PieterHaase/RPi-404/Version 1.0 (veraltet)/README.md

# README #

Projekt ITS/MoSy
Sommersemester 2018
Gruppe: RPi-404
