PieterHaase/RPi-404/Version 1.0 (veraltet)/Signalflussgraph.pdf

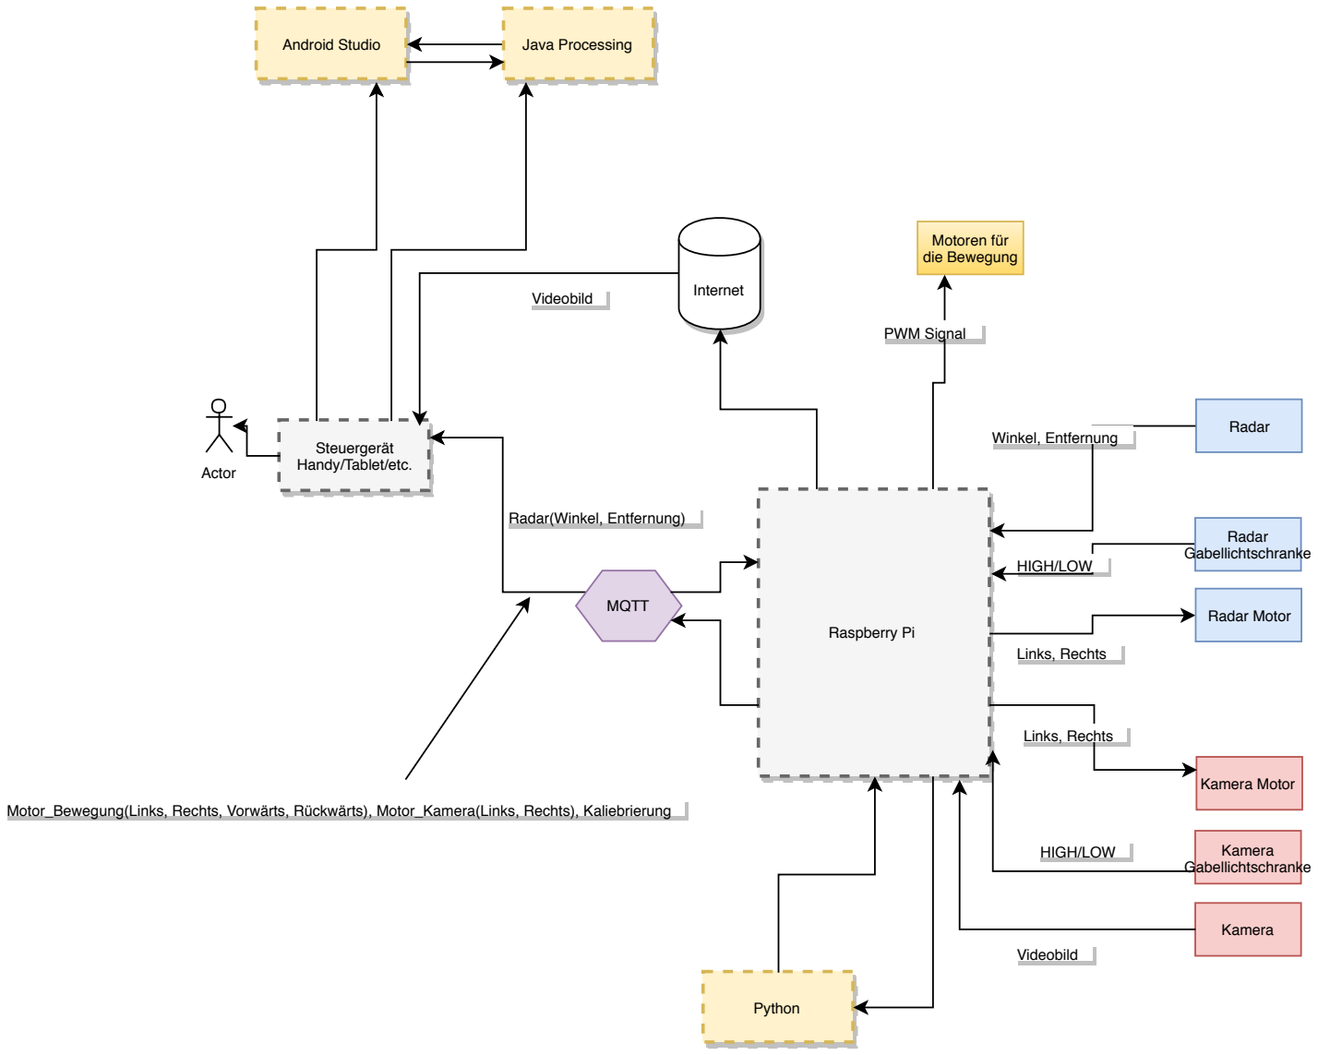
[picture p8: figure]
Raspberry Pi; Steuergerät Handy/Tablet/etc.; Android Studio; Java Processing; MQTT; Python; Radar; Radar Gabellichtschranke; Kamera Motor; Kamera; Kamera Gabellichtschranke; Motoren für die Bewegung; Actor; Radar Motor; Radar(Winkel, Entfernung); PWM Signal; Winkel, Entfernung; Links, Rechts; HIGH/LOW; Videobild; Internet

Motor_Bewegung(Links, Rechts, Vorwärts, Rückwärts), Motor_Kamera(Links, Rechts), Kaliebrierung
