PieterHaase/RPi-404/Version 1.0 (veraltet)/Fritzing/Sketch_Steckplatine.pdf

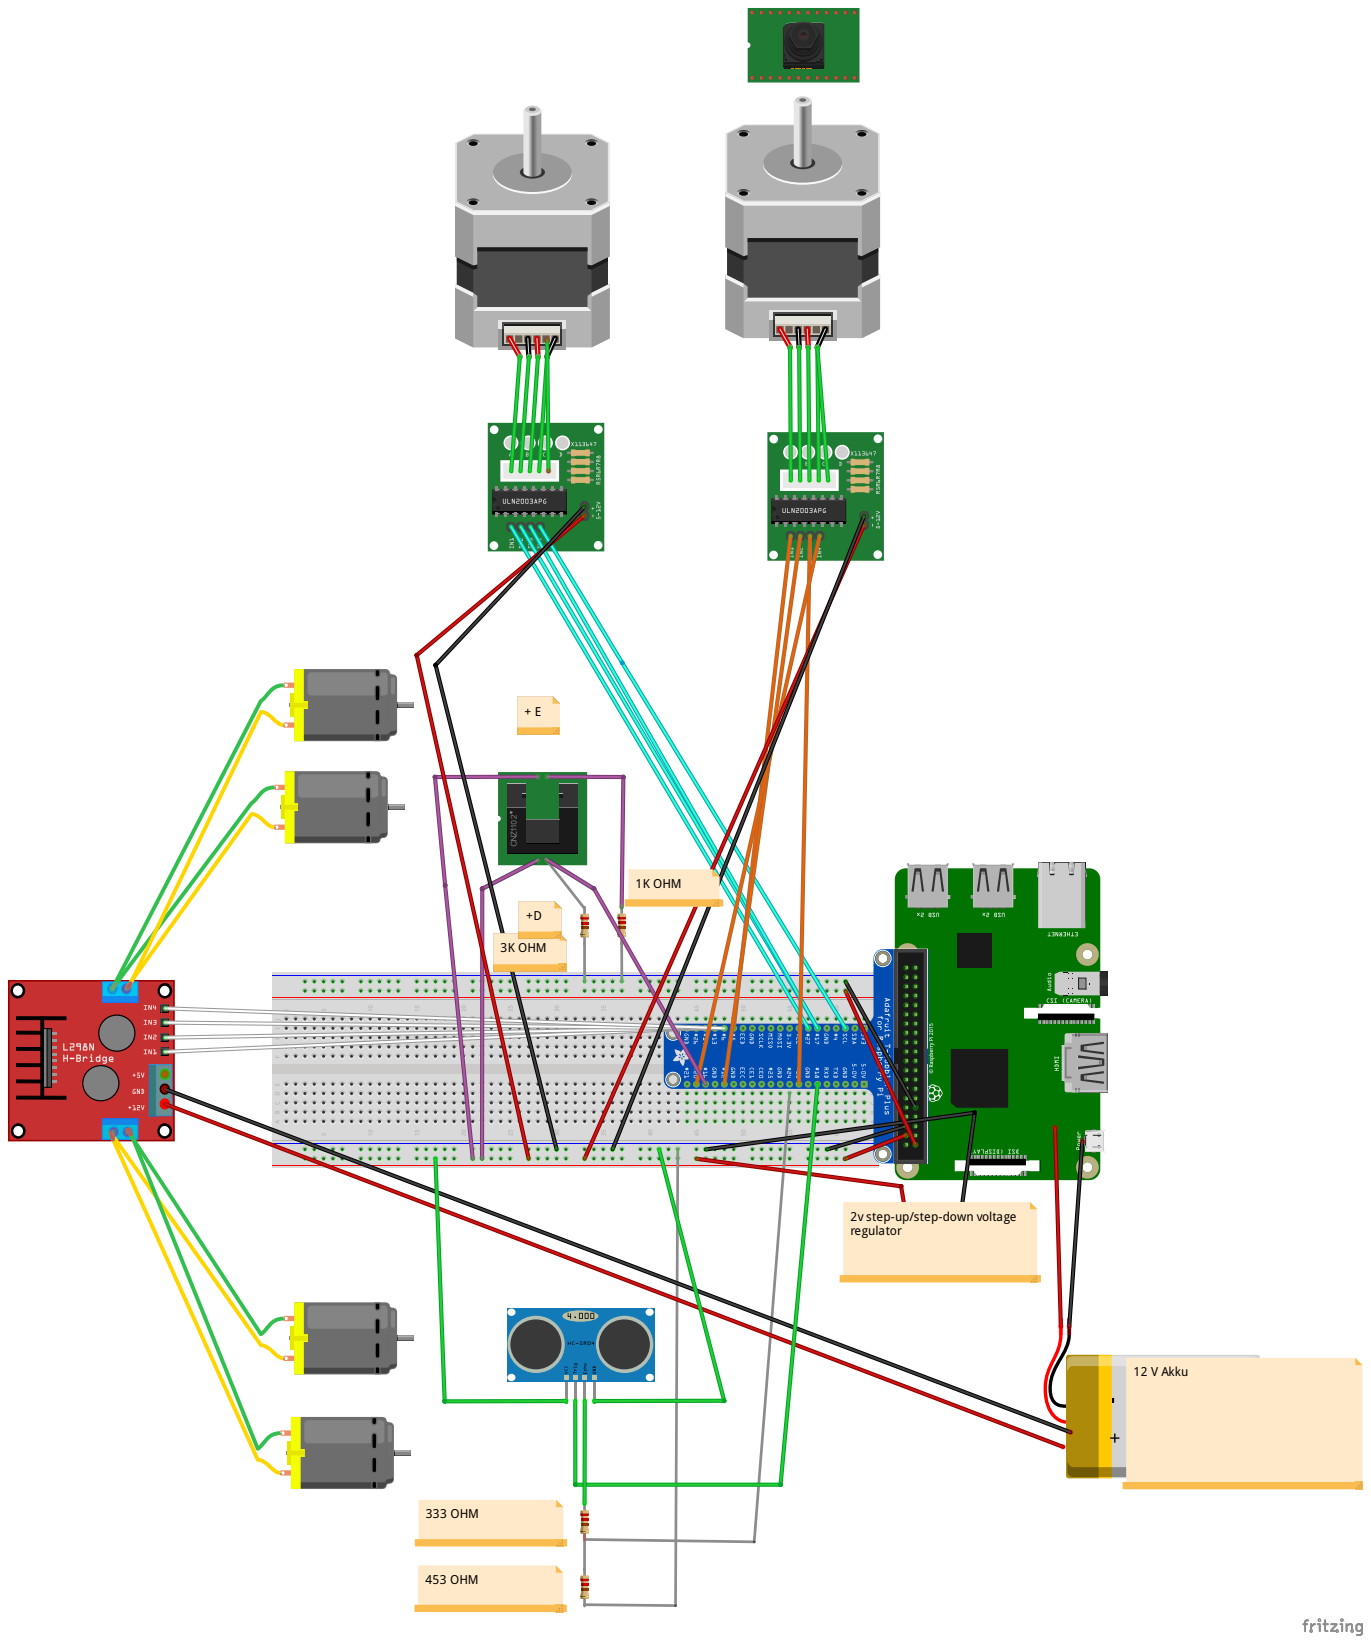
[picture p11: page 1]
333 OHM; 453 OHM; 1K OHM; 3K OHM; 12 V Akku

2v step-up/step-down voltage
regulator
