PieterHaase/RPi-404/(list of files, drawings)

Other design files:
Version 1.0 (veraltet)/Fritzing/Sketch.fzz
